tommag/Dynamo_minimal_USB_charger/fab/Dynamo_minimal_USB_charger_BoM.ods

Designator | Qty | Value | Package | TME order ref | Order qty
C1 | 1 | Bipolar/330uF/35V/lowESR | C_Radial_D12.5mm_H20.0mm_P5.00mm | UVP1V331MHD | 5
C2 | 1 | 1000uF/16V | CP_Radial_D12.5mm_P5.00mm | URS1C102MHD1TO | 5
C3 | 1 | 0.1uF/25V | C_Disc_D4.3mm_W1.9mm_P5.00mm
C4 | 1 | 100uF/10V | CP_Radial_D4.0mm_P2.00mm | UVR1A101MDD1TD | 5
D4,D3,D2,D1 | 4 | 1N5819 | D_DO-41_SOD81_P7.62mm_Horizontal | 1N5819RL | 20
D5 | 1 | 1.5KE15CA | D_DO-201AE_P12.70mm_Horizontal | 1.5KE15CA | 5
D6 | 1 | Green LED | LED_D3.0mm_Horizontal_O1.27mm_Z2.0mm | NTE30141 | 5
D7 | 1 | BZX55C6V8 | D_DO-35_SOD27_P7.62mm_Horizontal | BZX55C6V8-R0 | 5
D8 | 1 | Red LED | LED_D3.0mm_Horizontal_O1.27mm_Z2.0mm | NTE30140 | 5
J1 | 1 | Screw_Terminal_01x02 | TerminalBlock_Phoenix_MKDS-1,5-2_1x02_P5.00mm_Horizontal | SPTA1/2-5.0 | 5
J2 | 1 | USB_A | USB_A_Molex_67643_Horizontal | MX-67643-0910 | 5
R2,R1 | 2 | 1k | R_Axial_DIN0207_L6.3mm_D2.5mm_P7.62mm_Horizontal
SW1 | 1 | TCO/80°C/1A | SolderWire-0.5sqmm_1x02_P4.8mm_D0.9mm_OD2.3mm | AM03-80 | 5
U1 | 1 | LM1117-5.0 | TO252-2 | LD1117DT50 | 5
Enclosure | 1 | 1591XXASFLBK |  | HM-1591XXASFLBK | 5
Toggle switch | 1 | 639H |  | 639H | 5
Switch boot | 1 | U851 |  | U851 | 5
LED spacer | 2 |  |  | DR8GE04V80375 | 10
