tommag/Dynamo_minimal_USB_charger/Dynamo_minimal_USB_charger.kicad_pcb

## KiCad design Dynamo_minimal_USB_charger.kicad_pcb (2021-07-14)

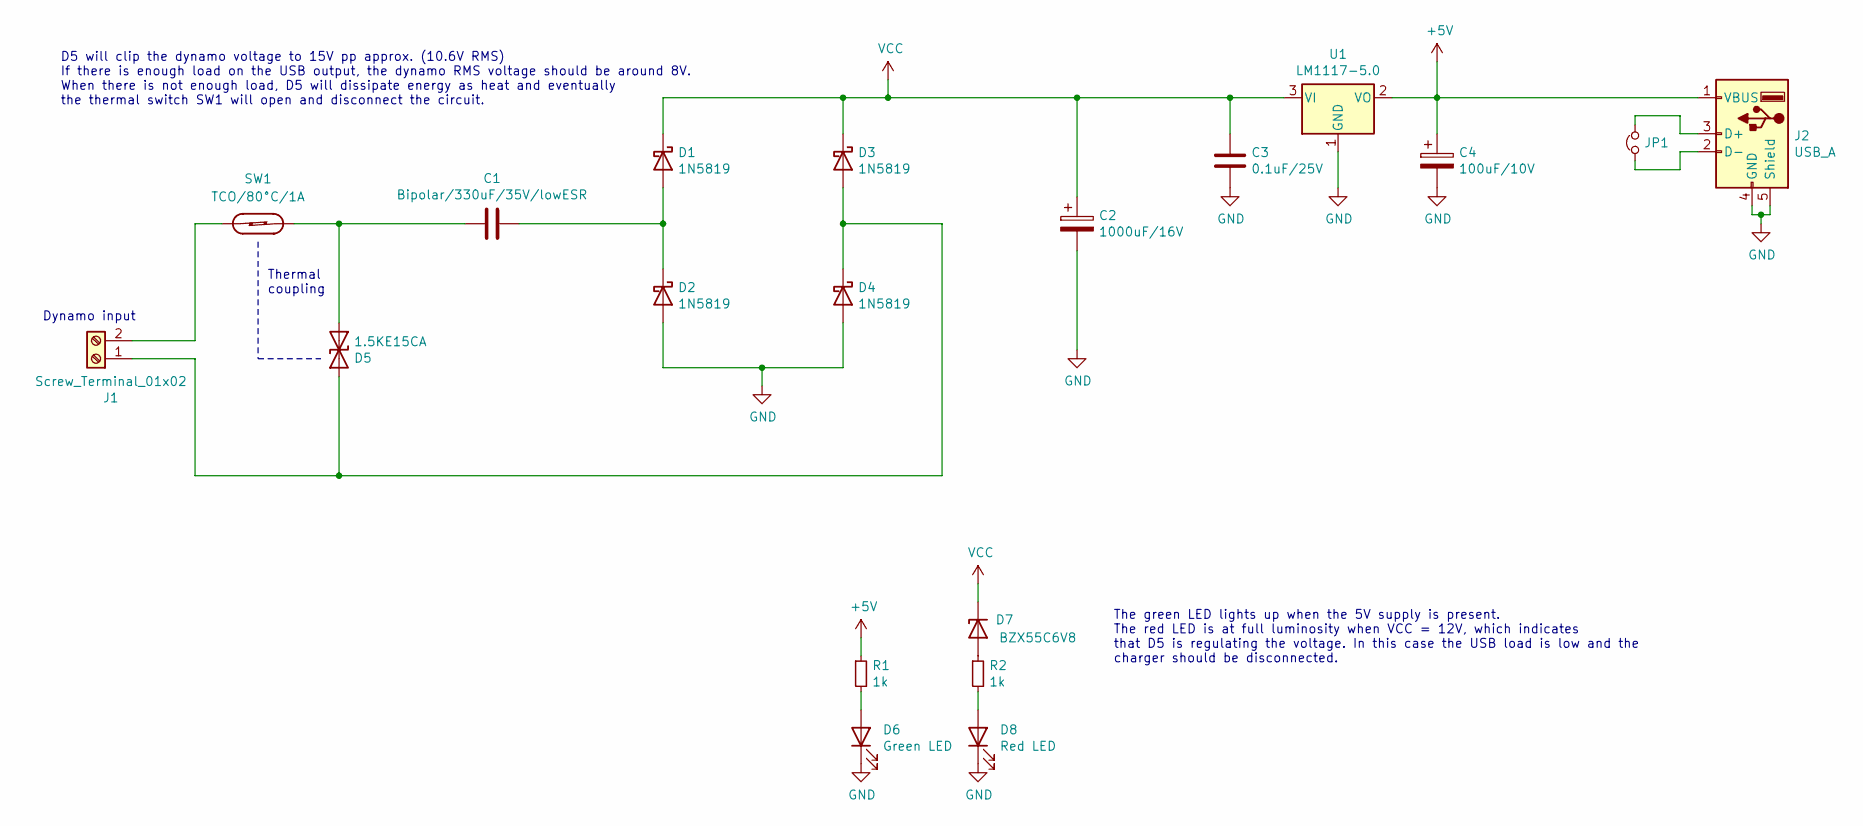
[picture p1: schematic Dynamo_minimal_USB_charger.sch, Hub dynamo minimal USB charger]

Parts:
C1: Bipolar/330uF/35V/lowESR; C_Radial_D12.5mm_H20.0mm_P5.00mm
C2: 1000uF/16V; CP_Radial_D12.5mm_P5.00mm
C3: 0.1uF/25V; C_Disc_D4.3mm_W1.9mm_P5.00mm
C4: 100uF/10V; CP_Radial_D4.0mm_P2.00mm
D1, D2, D3, D4: 1N5819; D_DO-41_SOD81_P7.62mm_Horizontal
D5: 1.5KE15CA; D_DO-201AE_P12.70mm_Horizontal
D6: Green LED; LED_D3.0mm_Horizontal_O1.27mm_Z2.0mm
D7: BZX55C6V8; D_DO-35_SOD27_P7.62mm_Horizontal
D8: Red LED; LED_D3.0mm_Horizontal_O1.27mm_Z2.0mm
J1: Screw_Terminal_01x02; TerminalBlock_Phoenix_MKDS-1,5-2_1x02_P5.00mm_Horizontal
J2: USB_A; USB_A_Molex_67643_Horizontal
JP1: Jumper_NC_Small; SolderJumper-2_P1.3mm_Bridged_RoundedPad1.0x1.5mm
R1, R2: 1k; R_Axial_DIN0207_L6.3mm_D2.5mm_P7.62mm_Horizontal
SW1: TCO/80°C/1A; SolderWire-0.5sqmm_1x02_P4.8mm_D0.9mm_OD2.3mm
U1: LM1117-5.0; TO-252-2

Connections:
+5V: C4.1, J2.1 (VBUS), R1.1, U1.2 (VO)
GND: C2.2, C3.2, C4.2, D2.2 (A), D4.2 (A), D6.1 (K), D8.1 (K), J2.4 (GND), J2.5 (Shield), U1.1 (GND)
unnamed: C1.1, D1.2 (A), D2.1 (K)
unnamed: C1.2, D5.2 (A2), SW1.2
unnamed: D3.2 (A), D4.1 (K), D5.1 (A1), J1.1
unnamed: D6.2 (A), R1.2
unnamed: D7.2 (A), R2.1
unnamed: D8.2 (A), R2.2
unnamed: J1.2, SW1.1
unnamed: J2.2 (D-), JP1.1
unnamed: J2.3 (D+), JP1.2
VCC: C2.1, C3.1, D1.1 (K), D3.1 (K), D7.1 (K), U1.3 (VI)

Notes on the sheet:
Thermal coupling
The green LED lights up when the 5V supply is present. The red LED is at full luminosity when VCC = 12V, which indicates that D5 is regulating the voltage. In this case the USB load is low and the charger should be disconnected.
D5 will clip the dynamo voltage to 15V pp approx. (10.6V RMS) If there is enough load on the USB output, the dynamo RMS voltage should be around 8V. When there is not enough load, D5 will dissipate energy as heat and eventually the thermal switch SW1 will open and disconnect the circuit.
Dynamo input

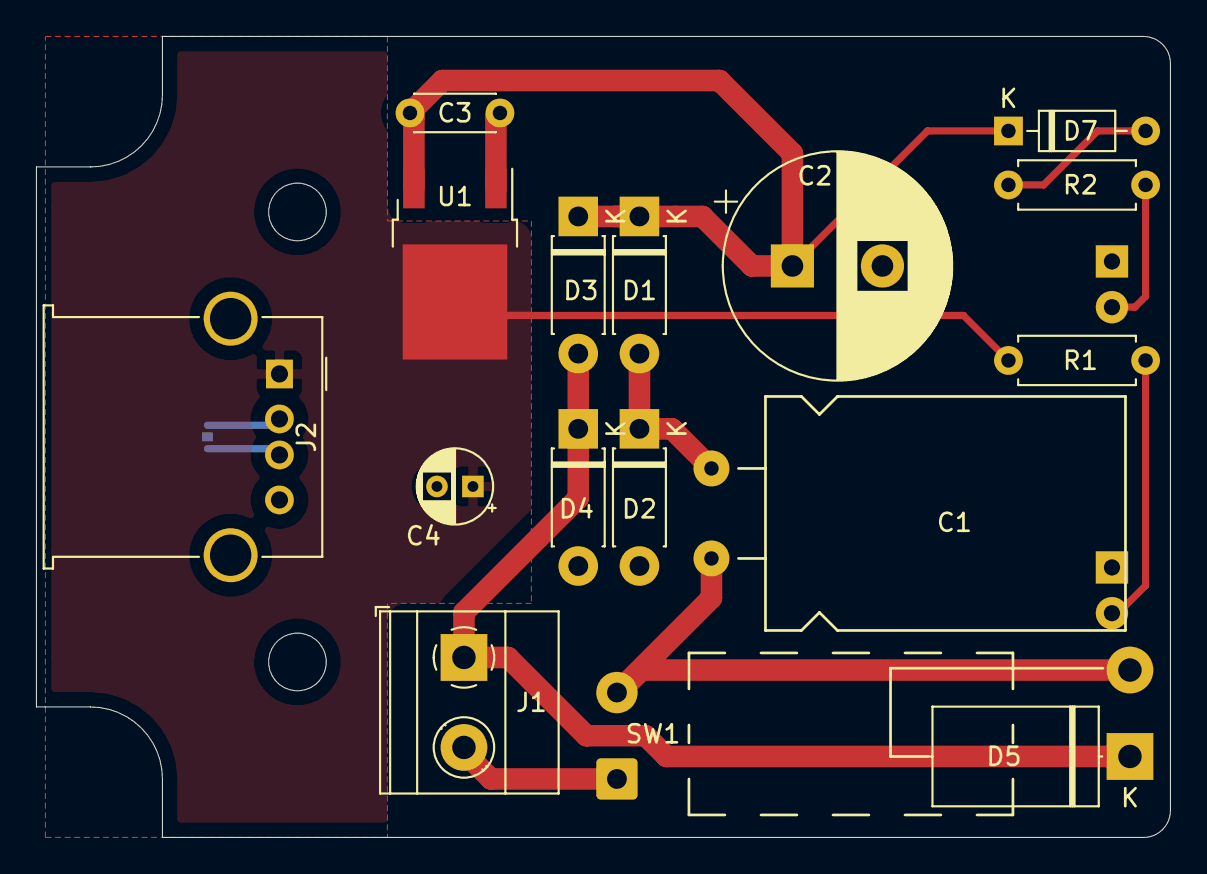
[picture p2: board Dynamo_minimal_USB_charger.kicad_pcb from above]

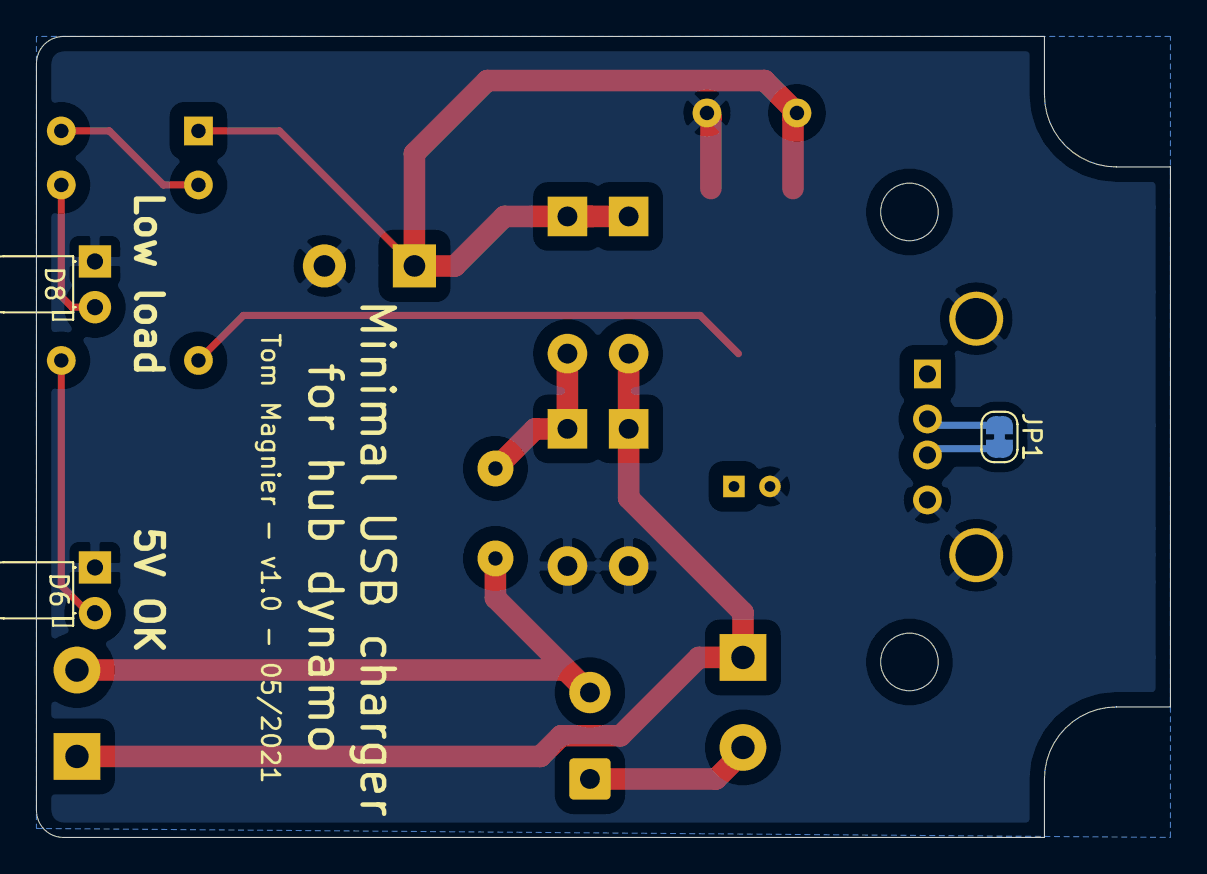
[picture p3: board Dynamo_minimal_USB_charger.kicad_pcb from below]

Board: 2 copper layers, 63.0 x 44.5 mm, 19 parts (3 on the bottom side), 12 nets.
